fotherja/CLLLC_DAB/README.md

# CLLLC_DAB
CLLLC Dual active Bridge resonant converter v1
