fotherja/CLLLC_DAB/KiCad_and_Gerbers/Resonant_Converter_V1/Resonant_Converter_V1.kicad_pcb

## KiCad design KiCad_and_Gerbers/Resonant_Converter_V1/Resonant_Converter_V1.kicad_pcb (2023-07-22)

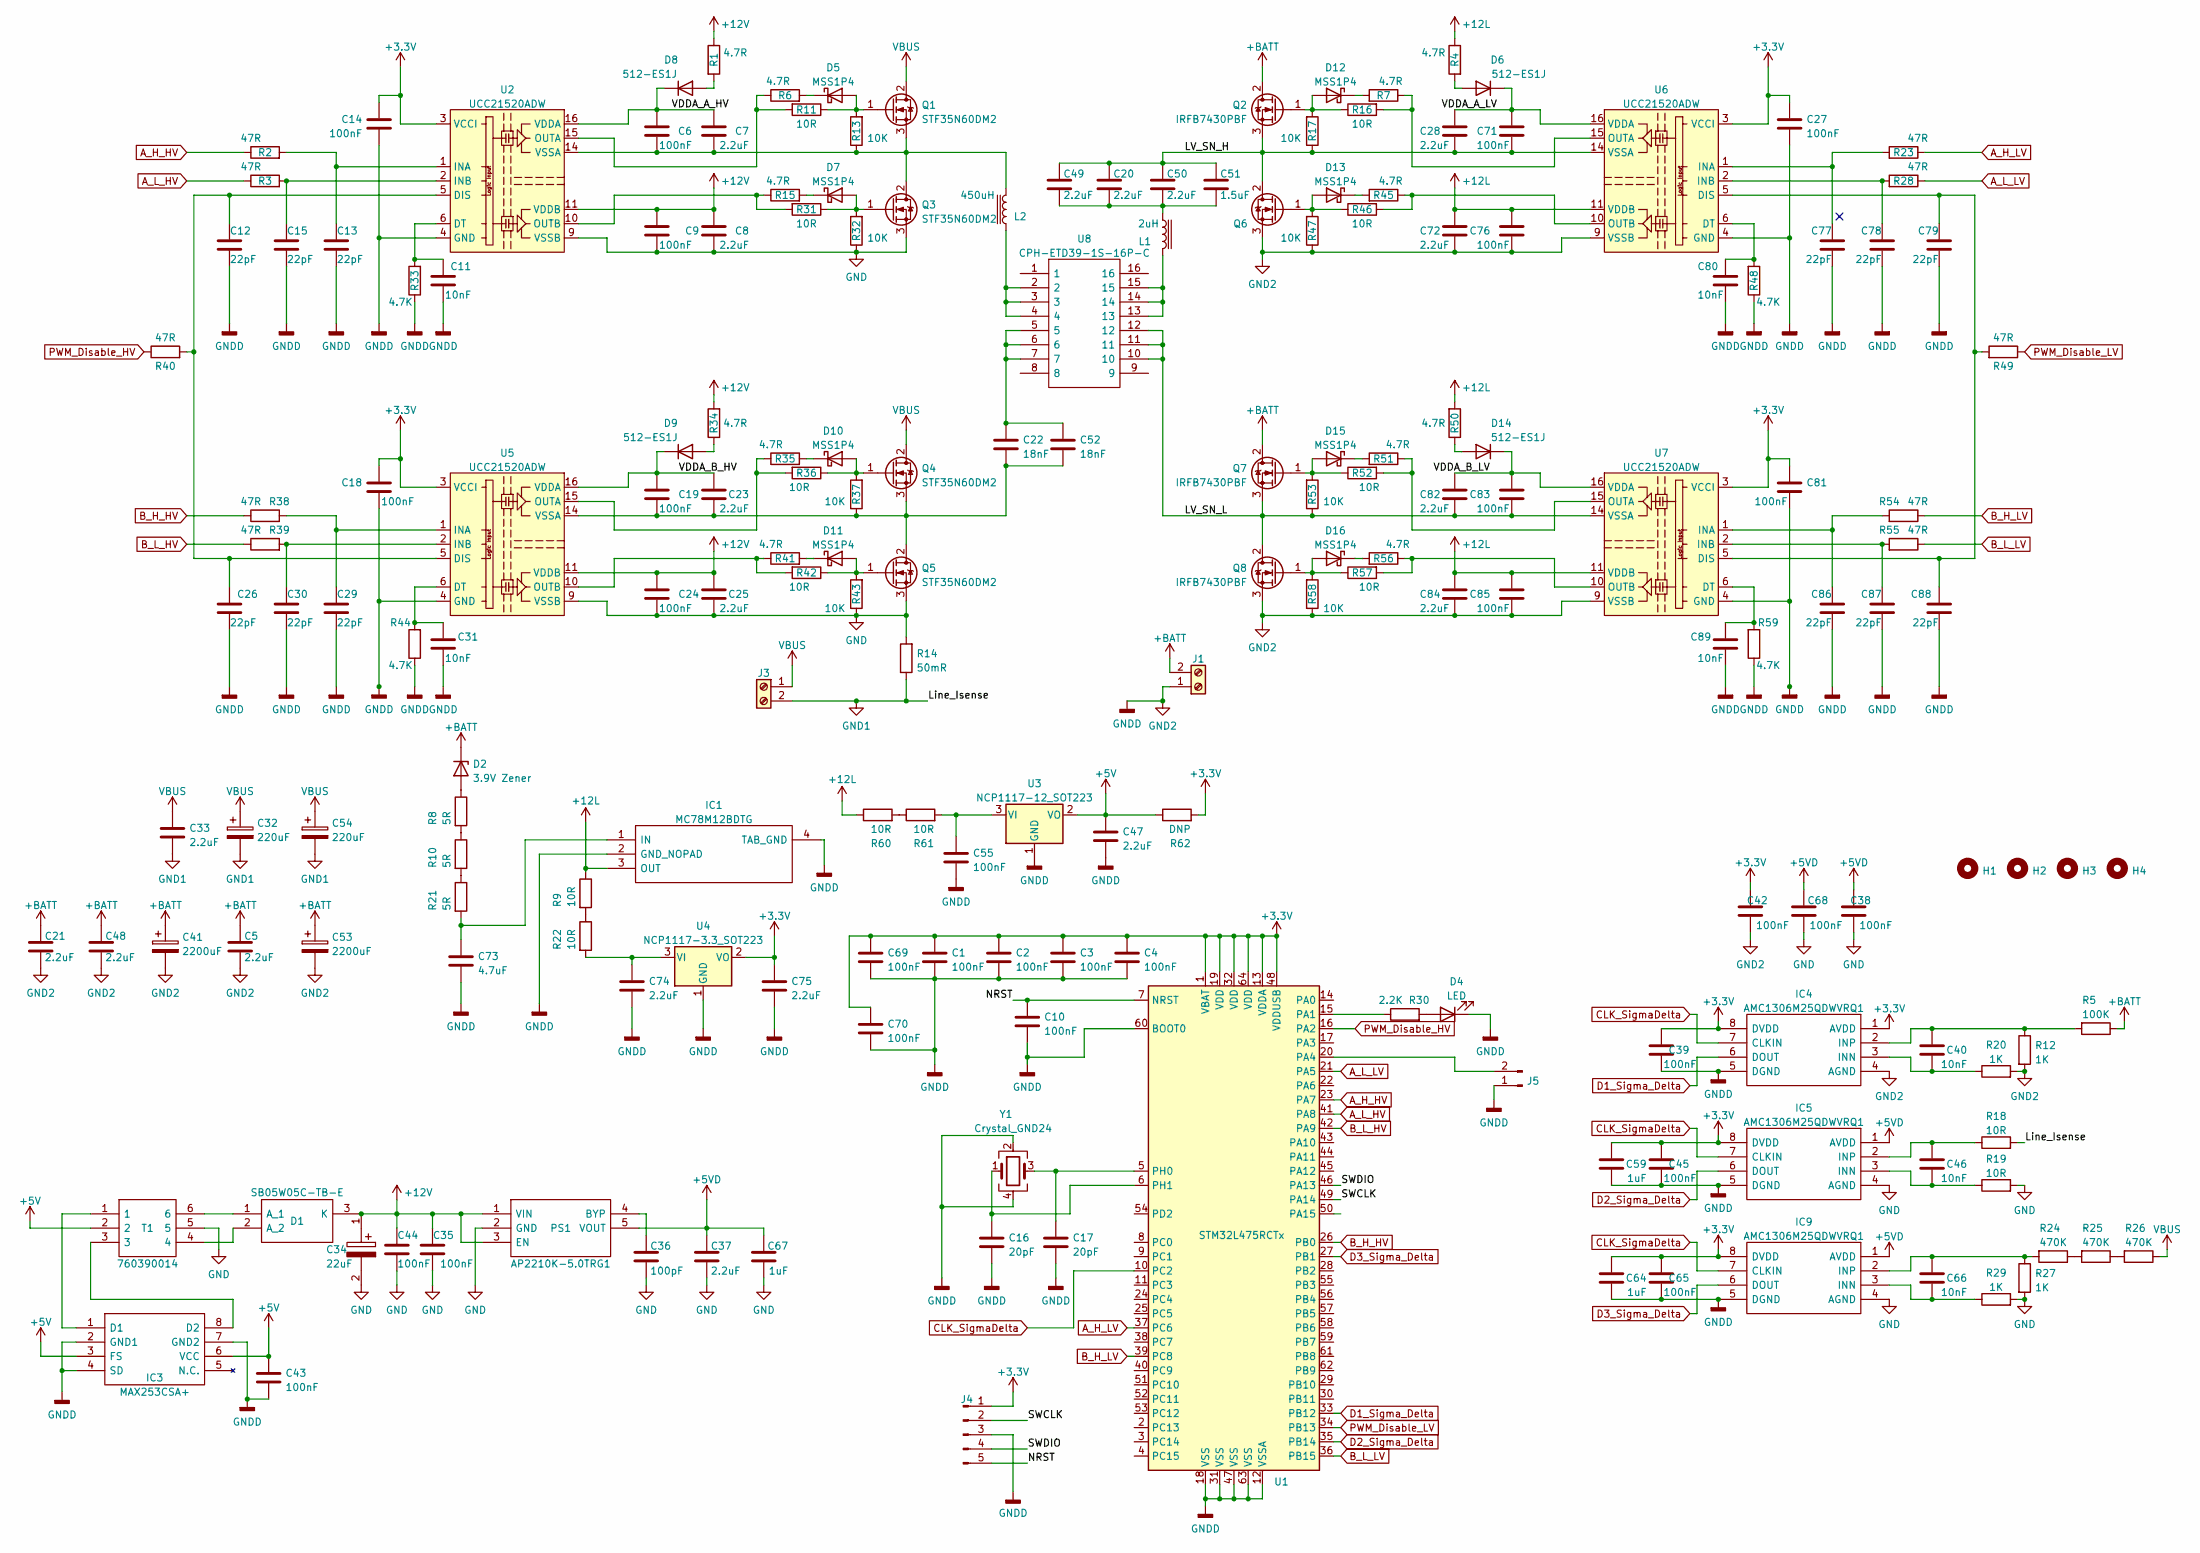
[picture p1: schematic Resonant_Converter_V1.kicad_sch, GTI version 5]

Parts:
C1, C2, C3, C4, C6, C9, C10, C14, C18, C19, C24, C27, C35, C38, C39, C42, C43, C44, C45, C55, C65, C68, C69, C70, C71, C76, C81, C83, C85: 100nF; C_0603_1608Metric
C5, C21, C48: 2.2uF; C_Rect_L13.0mm_W6.0mm_P10.00mm_FKS3_FKP3_MKS4
C7, C8, C23, C25, C28, C37, C47, C72, C74, C75, C82, C84: 2.2uF; C_0603_1608Metric
C11, C31, C40, C46, C66, C80, C89: 10nF; C_0603_1608Metric
C12, C13, C15, C26, C29, C30, C77, C78, C79, C86, C87, C88: 22pF; C_0603_1608Metric
C16, C17: 20pF; C_0603_1608Metric
C20, C49, C50: 2.2uF; C_Rect_L10.3mm_W7.2mm_P7.50mm_MKS4
C22, C52: 18nF; C_Rect_L13.0mm_W8.0mm_P10.00mm_FKS3_FKP3_MKS4
C32, C54: 220uF; CP_Radial_D25.0mm_P10.00mm_SnapIn
C33: 2.2uF; C_Rect_L13.0mm_W8.0mm_P10.00mm_FKS3_FKP3_MKS4
C34: 22uF; CAPPC3328X220N; Mouser Part Number 74-595D226X9020B2T
C36: 100pF; C_0603_1608Metric
C41, C53: 2200uF; CP_Radial_D18.0mm_P7.50mm
C51: 1.5uF; C_Rect_L10.3mm_W7.2mm_P7.50mm_MKS4
C59, C64, C67: 1uF; C_0603_1608Metric
C73: 4.7uF; C_0805_2012Metric
D1: SB05W05C-TB-E; SOT95P250X135-3N; Mouser Part Number 863-SB05W05C-TB-E
D2: 3.9V Zener; D_5W_P5.08mm_Vertical_AnodeUp
D4: LED; LED_0603_1608Metric
D5, D7, D10, D11, D12, D13, D15, D16: MSS1P4; D_MicroSMP
D6, D8, D9, D14: 512-ES1J; D_SMA
H1, H2, H3, H4: MountingHole; MountingHole_3.2mm_M3
IC1: MC78M12BDTG; TO229P990X238-4N; Mouser Part Number 863-MC78M12BDTG
IC3: MAX253CSA+; SOIC127P600X175-8N; Mouser Part Number 700-MAX253CSA
IC4, IC5, IC9: AMC1306M25QDWVRQ1; SOIC127P1150X280-8N; Mouser Part Number 595-MC1306M25QDWVRQ1
J1, J3: Screw_Terminal_01x02; TerminalBlock_bornier-2_P5.08mm
J4: Conn_01x05_Male; PinHeader_1x05_P1.27mm_Vertical
J5: Conn_01x02_Male; PinHeader_1x02_P1.27mm_Vertical
L1: 2uH; L_Toroid_Vertical_L28.6mm_W14.3mm_P11.43mm_Bourns_5700
L2: 450uH; L_Toroid_Vertical_L28.6mm_W14.3mm_P11.43mm_Bourns_5700
PS1: AP2210K-5.0TRG1; SOT95P282X130-5N; Mouser Part Number 621-AP2210K-5.0TRG1
Q1, Q3, Q4, Q5: STF35N60DM2; TO-220-3_Vertical
Q2, Q6, Q7, Q8: IRFB7430PBF; TO-220-3_Vertical
R1, R4, R6, R7, R15, R34, R35, R41, R45, R50, R51, R56: 4.7R; R_0603_1608Metric
R2, R3, R23, R28, R38, R39, R40, R49, R54, R55: 47R; R_0603_1608Metric
R5: 100K; R_0805_2012Metric
R8, R10, R21: 5R; R_0805_2012Metric
R9, R22, R60, R61: 10R; R_0805_2012Metric
R11, R16, R18, R19, R31, R36, R42, R46, R52, R57: 10R; R_0603_1608Metric
R12, R20, R27, R29: 1K; R_0603_1608Metric
R13, R17, R32, R37, R43, R47, R53, R58: 10K; R_0603_1608Metric
R14: 50mR; R_2512_6332Metric
R24, R25, R26: 470K; R_0805_2012Metric
R30: 2.2K; R_0603_1608Metric
R33, R44, R48, R59: 4.7K; R_0603_1608Metric
R62: DNP; R_0603_1608Metric
T1: 760390014; 760390015; Mouser Part Number 710-760390014
U1: STM32L475RCTx; LQFP-64_10x10mm_P0.5mm
U2, U5, U6, U7: UCC21520ADW; SOIC-16W_7.5x10.3mm_P1.27mm
U3: NCP1117-12_SOT223; SOT-223-3_TabPin2
U4: NCP1117-3.3_SOT223; SOT-223-3_TabPin2
U8: CPH-ETD39-1S-16P-C; ETD39-VER-16P; Manufacturer_Part_Number CPH-ETD39-1S-16P-C
Y1: Crystal_GND24; Crystal_SMD_Abracon_ABM10-4Pin_2.5x2.0mm

Connections:
+3.3V: C1.1, C2.1, C3.1, C4.1, C14.2, C18.2, C27.2, C39.1, C42.1, C45.1, C59.1, C64.1, C65.1, C69.1, C70.1, C75.1, C81.2, IC4.1 (AVDD), IC4.8 (DVDD), IC5.8 (DVDD), IC9.8 (DVDD), J4.1, R62.2, U1.1 (VBAT), U1.13 (VDDA), U1.19 (VDD), U1.32 (VDD), U1.48 (VDDUSB), U1.64 (VDD), U2.3 (VCCI), U2.8 (VCCI), U4.2 (VO), U5.3 (VCCI), U5.8 (VCCI), U6.3 (VCCI), U6.8 (VCCI), U7.3 (VCCI), U7.8 (VCCI)
+5V: C43.1, C47.1, IC3.3 (FS), IC3.6 (VCC), R62.1, T1.2, U3.2 (VO)
+5VD: C37.1, C38.1, C67.1, C68.1, IC5.1 (AVDD), IC9.1 (AVDD), PS1.5 (VOUT)
+12L: C72.1, C76.2, C84.1, C85.2, IC1.3 (OUT), R4.1, R9.1, R50.2, R60.1, U6.11 (VDDB), U7.11 (VDDB)
+12V: C8.1, C9.2, C24.2, C25.1, C34.1, C35.1, C44.1, D1.3 (K), PS1.1 (VIN), PS1.3 (EN), R1.1, R34.2, U2.11 (VDDB), U5.11 (VDDB)
+BATT: C5.1, C21.1, C41.1, C48.1, C53.1, D2.1 (K), J1.2, Q2.2 (D), Q7.2 (D), R5.1
/LV_SN_H: C20.1, C28.2, C49.1, C50.1, C51.1, C71.2, Q2.3 (S), Q6.2 (D), R17.1, U6.14 (VSSA)
/LV_SN_L: C82.2, C83.1, Q7.3 (S), Q8.2 (D), R53.1, U7.14 (VSSA), U8.10, U8.11, U8.12
/NRST: C10.1, J4.5, U1.7 (NRST)
/SWCLK: J4.2, U1.49 (PA14)
/SWDIO: J4.4, U1.46 (PA13)
/VDDA_A_HV: C6.1, C7.1, D8.1 (K), U2.16 (VDDA)
/VDDA_A_LV: C28.1, C71.1, D6.1 (K), U6.16 (VDDA)
/VDDA_B_HV: C19.2, C23.1, D9.1 (K), U5.16 (VDDA)
/VDDA_B_LV: C82.1, C83.2, D14.1 (K), U7.16 (VDDA)
A_H_HV: R2.1, U1.23 (PA7)
A_H_LV: R23.1, U1.37 (PC6)
A_L_HV: R3.1, U1.41 (PA8)
A_L_LV: R28.1, U1.21 (PA5)
B_H_HV: R38.1, U1.26 (PB0)
B_H_LV: R54.1, U1.39 (PC8)
B_L_HV: R39.1, U1.42 (PA9)
B_L_LV: R55.1, U1.36 (PB15)
CLK_SigmaDelta: IC4.7 (CLKIN), IC5.7 (CLKIN), IC9.7 (CLKIN), U1.10 (PC2)
D1_Sigma_Delta: IC4.6 (DOUT), U1.33 (PB12)
D2_Sigma_Delta: IC5.6 (DOUT), U1.35 (PB14)
D3_Sigma_Delta: U1.38 (PC7)
D4_Sigma_Delta: IC9.6 (DOUT), U1.27 (PB1)
GND: C8.2, C9.1, C24.1, C25.2, C34.2, C35.2, C36.2, C37.2, C38.2, C44.2, C67.2, C68.2, IC5.4 (AGND), IC9.4 (AGND), PS1.2 (GND), Q3.3 (S), Q5.3 (S), R14.2, R19.2, R27.2, R29.2, R32.1, R43.1, T1.5, U2.9 (VSSB), U5.9 (VSSB)
GND1: C32.2, C33.2, C54.2, J3.2, R14.1, R18.2
GND2: C1.2, C2.2, C3.2, C4.2, C5.2, C10.2, C11.1, C12.2, C13.2, C14.1, C15.2, C16.2, C17.2, C18.1, C21.2, C26.2, C27.1, C29.2, C30.2, C31.1, C39.2, C41.2, C42.2, C43.2, C45.2, C47.2, C48.2, C53.2, C55.2, C59.2, C64.2, C65.2, C69.2, C70.2, C72.2, C73.2, C74.2, C75.2, C76.1, C77.2, C78.2, C79.2, C80.1, C81.1, C84.2, C85.1, C86.2, C87.2, C88.2, C89.1, D4.1 (K), IC1.2 (GND_NOPAD), IC1.4 (TAB_GND), IC3.2 (GND1), IC3.4 (SD), IC3.7 (GND2), IC4.4 (AGND), IC4.5 (DGND), IC5.5 (DGND), IC9.5 (DGND), J1.1, J4.3, J5.1, Q6.3 (S), Q8.3 (S), R12.2, R20.2, R33.1, R44.1, R47.1, R48.1, R58.1, R59.1, U1.12 (VSSA), U1.18 (VSS), U1.31 (VSS), U1.47 (VSS), U1.60 (BOOT0), U1.63 (VSS), U2.4 (GND), U3.1 (GND), U4.1 (GND), U5.4 (GND), U6.4 (GND), U6.9 (VSSB), U7.4 (GND), U7.9 (VSSB), Y1.2, Y1.4
unnamed: C6.2, C7.2, L2.2, Q1.3 (S), Q3.2 (D), R13.1, U2.14 (VSSA)
unnamed: C11.2, R33.2, U2.6 (DT)
unnamed: C12.1, C26.1, R40.2, U2.5 (DIS), U5.5 (DIS)
unnamed: C13.1, R2.2, U2.1 (INA)
unnamed: C15.1, R3.2, U2.2 (INB)
unnamed: C16.1, U1.6 (PH1), Y1.1
unnamed: C17.1, U1.5 (PH0), Y1.3
unnamed: C19.1, C22.2, C23.2, C52.2, Q4.3 (S), Q5.2 (D), R37.1, U5.14 (VSSA)
unnamed: C20.2, C49.2, C50.2, C51.2, L1.2
unnamed: C22.1, C52.1, U8.5, U8.6, U8.7
unnamed: C29.1, R38.2, U5.1 (INA)
unnamed: C30.1, R39.2, U5.2 (INB)
unnamed: C31.2, R44.2, U5.6 (DT)
unnamed: C36.1, PS1.4 (BYP)
unnamed: C40.1, IC4.2 (INP), R5.2, R12.1
unnamed: C40.2, IC4.3 (INN), R20.1
unnamed: C46.1, IC5.2 (INP), R18.1
unnamed: C46.2, IC5.3 (INN), R19.1
unnamed: C66.1, IC9.2 (INP), R24.2, R27.1
unnamed: C66.2, IC9.3 (INN), R29.1
unnamed: C73.1, IC1.1 (IN), R21.2
unnamed: C74.1, R22.2, U4.3 (VI)
unnamed: C77.1, R23.2, U6.1 (INA)
unnamed: C78.1, R28.2, U6.2 (INB)
unnamed: C79.1, C88.1, R49.2, U6.5 (DIS), U7.5 (DIS)
unnamed: C80.2, R48.2, U6.6 (DT)
unnamed: C86.1, R54.2, U7.1 (INA)
unnamed: C87.1, R55.2, U7.2 (INB)
unnamed: C89.2, R59.2, U7.6 (DT)
unnamed: D1.1 (A_1), T1.6
unnamed: D1.2 (A_2), T1.4
unnamed: D2.2 (A), R8.1
unnamed: D4.2 (A), R30.2
unnamed: D5.1 (K), R6.2
unnamed: D5.2 (A), Q1.1 (G), R11.1, R13.2
unnamed: D6.2 (A), R4.2
unnamed: D7.1 (K), R15.2
unnamed: D7.2 (A), Q3.1 (G), R31.1, R32.2
unnamed: D8.2 (A), R1.2
unnamed: D9.2 (A), R34.1
unnamed: D10.1 (K), R35.2
unnamed: D10.2 (A), Q4.1 (G), R36.1, R37.2
unnamed: D11.1 (K), R41.2
unnamed: D11.2 (A), Q5.1 (G), R42.1, R43.2
unnamed: D12.1 (K), R7.2
unnamed: D12.2 (A), Q2.1 (G), R16.1, R17.2
unnamed: D13.1 (K), R45.2
unnamed: D13.2 (A), Q6.1 (G), R46.1, R47.2
unnamed: D14.2 (A), R50.1
unnamed: D15.1 (K), R51.2
unnamed: D15.2 (A), Q7.1 (G), R52.1, R53.2
unnamed: D16.1 (K), R56.2
unnamed: D16.2 (A), Q8.1 (G), R57.1, R58.2
unnamed: IC3.1 (D1), T1.1
unnamed: IC3.8 (D2), T1.3
unnamed: J5.2, U1.20 (PA4)
unnamed: L1.1, U8.13, U8.14, U8.15
unnamed: L2.1, U8.2, U8.3, U8.4
unnamed: R8.2, R10.1
unnamed: R10.2, R21.1
unnamed: R6.1, R11.2, U2.15 (OUTA)
unnamed: R15.1, R31.2, U2.10 (OUTB)
unnamed: R7.1, R16.2, U6.15 (OUTA)
unnamed: R9.2, R22.1
unnamed: R24.1, R25.2
unnamed: R25.1, R26.2
unnamed: R30.1, U1.15 (PA1)
unnamed: R35.1, R36.2, U5.15 (OUTA)
unnamed: R41.1, R42.2, U5.10 (OUTB)
unnamed: R45.1, R46.2, U6.10 (OUTB)
unnamed: R51.1, R52.2, U7.15 (OUTA)
unnamed: R56.1, R57.2, U7.10 (OUTB)
unnamed: R60.2, R61.1
unnamed: C55.1, R61.2, U3.3 (VI)
PWM_Disable_HV: R40.1, U1.16 (PA2)
PWM_Disable_LV: R49.1, U1.34 (PB13)
VBUS: C32.1, C33.1, C54.1, J3.1, Q1.2 (D), Q4.2 (D), R26.1

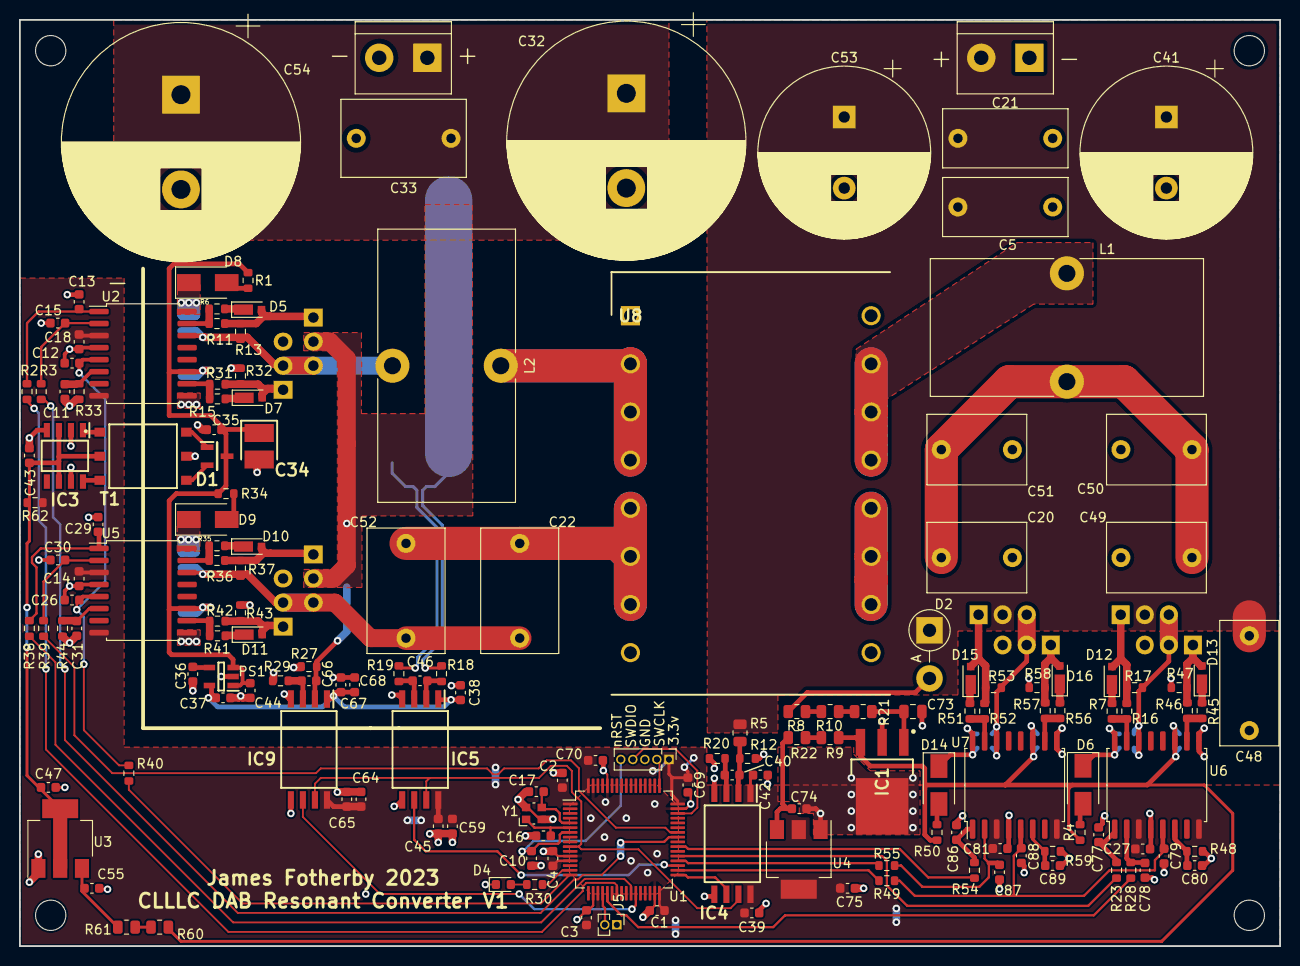
[picture p2: board Resonant_Converter_V1.kicad_pcb from above]

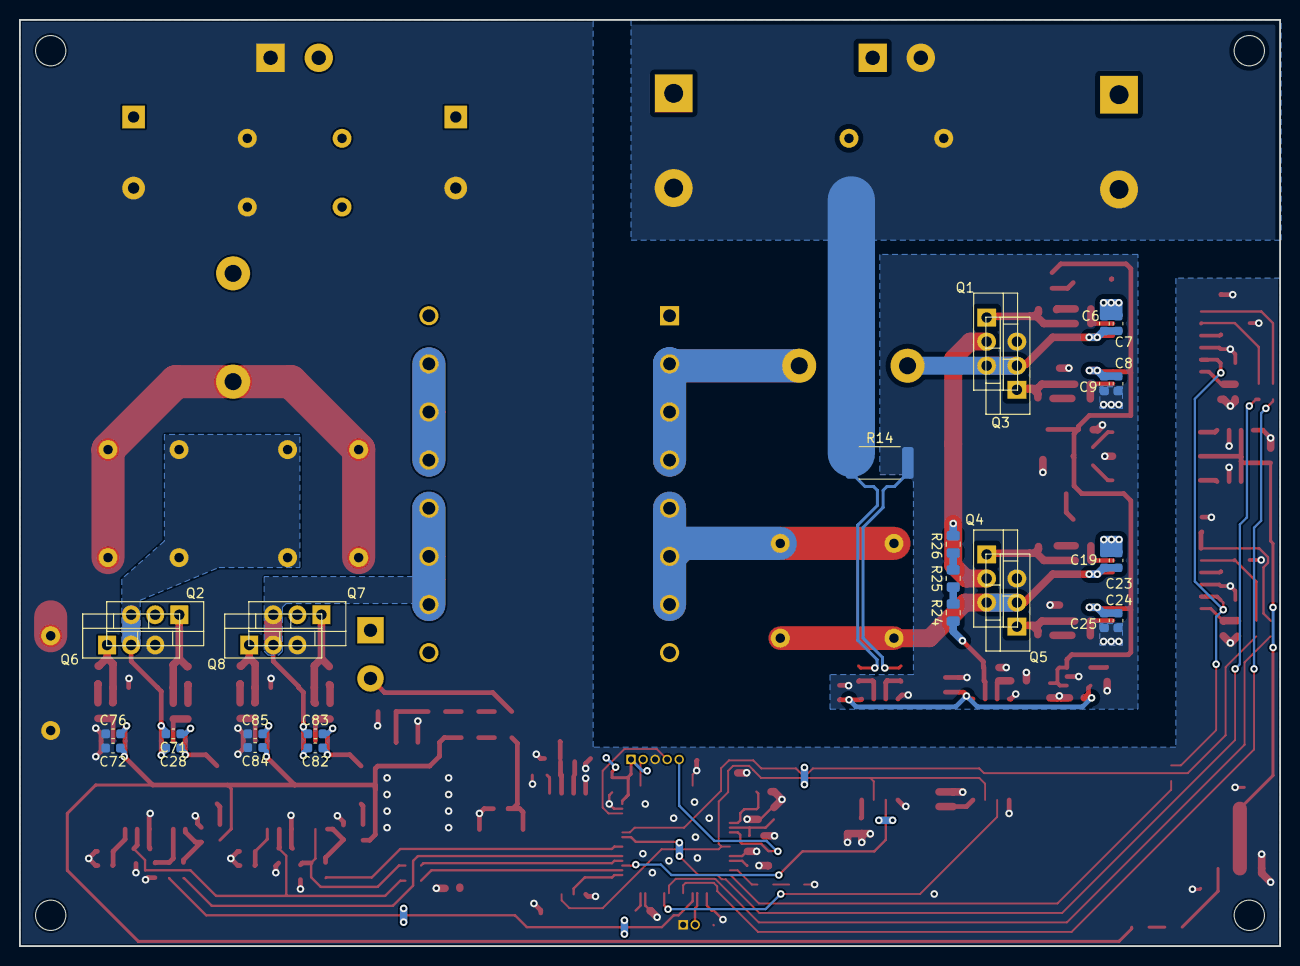
[picture p3: board Resonant_Converter_V1.kicad_pcb from below]

Board: 2 copper layers, 133.0 x 97.8 mm, 193 parts (28 on the bottom side), 107 nets.
