fotherja/CLLLC_DAB/(commit log)

2023-07-16 KiCad upload
    KiCad and gerbers uploaded for v1 PCB
    [Resonant_Converter_V1-B_Cu.gbr, Resonant_Converter_V1-B_Mask.gbr, Resonant_Converter_V1-B_Paste.gbr, Resonant_Converter_V1-B_Silkscreen.gbr, Resonant_Converter_V1-Edge_Cuts.gbr, Resonant_Converter_V1-F_Cu.gbr, Resonant_Converter_V1-F_Mask.gbr, Resonant_Converter_V1-F_Paste.gbr]
2023-07-22 Small mods to schematic
    [Resonant_Converter_V1.kicad_pcb, Resonant_Converter_V1.kicad_sch]
